BobGlicksman/Annunciator/Hardware/Annunciator parts list.pdf

ITEM | PART NUMBER | MFG OR URL | DESCRIPTION | QTY | UNIT COST EXTENDED COST | NOTES
1 Y11-2800069A | JLCPCB | Animatronic Mouth PCB | 1 | $2.33 | $2.33 total of 10 boards on order
2 Photon | Particle | Particle Photon 1 | 1 | $20.00 | $20.00
| | | | | | I also have 5 non-P versions -- slightly higher power but they work fine.

3

### 12 position female pin

header

https://www.amazon.com/Chanzon-Straight-Connector-Breadboard-Electronic/dp/B09MYKK2LV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 nRYEE9crsHyvb23IP-20ZdZeSVpxvLQWY8b1HdikOeQXo55bN5OvMTJjQL FRWxnOPZgaVZfYDvwrfyCHepdl4O8RvLrjoj43uc4O9xBdr-1iHb4tNBI4Tawv0GX3YywN8-H7Nls2inTW9yNwj-L23P9FFmD5l5ra8m0XVdx2YJUGXv07NFlGx5vGHzk 7ZFUFrYhaRYK8cK1jigX4Dxft1rs.0LHUbsUPH67owT L6byUosg1IiVrwncu3ehRr6-
jXavk&dib_tag=se&keywords=12%2Bpin%2Bfemale
%2Bheader&qid=1744849629&sprefix=12%2Bpin%
2Bfemale%2Bheader%2Caps%2C258&sr=8-4&th=1 12 pin female header, pcb mount | 2 | $0.50 | $1.00 URL is for 10 pcs

4 74HCT125N

https://www.digikey.com/en/products/detail/texas-
instruments/SN74HCT125N/376860 | Quad Tristate driver, TTL level, non-inv. | 1 | $0.63 | $0.63

### 5 Socket, 14 pin

https://www.amazon.com/uxcell-2-54mm-Soldering-Socket-Adaptor/dp/B07H3WQYRQ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 EALaU3pVoE1LwHUuFkKhaxR6vCGmxljUArKusNRUKvnl A-VRif2UGHYDCarszrOfulmSilFftBcoGowjmH3BneBfIw08VRZCU3pqD1gH5IPZfksUx-Th7oCVgRJOAkPr0ZbPxcMwBGcvB7RXs0kBuCuzddkaqe6pv aMmh19ilpAqmxtK9S_RUCmzYH04kI61MIibgpgspTp h-lE0pbnwvU.icjyUkQsbgvTHvpMFriUBUrfxbnpt2abpGHPsOCUZE&dib_tag=se&keywords=14
+pin+DIP+socket&qid=1744761619&sprefix=14+pin
+dip+socket%2Caps%2C251&sr=8-3 | 14 pin DIP socket | 1 | $0.17 | $0.17 URL is for 40 pcs

### 6 Mini MP3 player

https://www.amazon.com/dp/B08V8G1TQZ?ref=ppx
_yo2ov_dt_b_fed_asin_title&th=1 | DF Player mini MP3 Player Module | 1 | $2.25 | $2.25 URL is for 4 pcs

7 8 pin female pin header

https://www.amazon.com/Yohii-Female-Headers-2-54mm-Single/dp/B07PLBC2GT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 5ALn7GxSpyurLsKLO7Mo0innP73vNRrW2urV9aZzf7 R9ZNpbpXsr85012Vc7eYjePs6cmqFkM2PMgXwEQR THL4drI8LmCivl1xsj0kDyehfGPwIdw5KbTMyKq_ICdT DcA-HBCNLd7zU0Mqh03WsxYAuKVKsJSIlvwjlBN54N4fh 271EIu8QTKFcZrYUSP6mGxgcui8z2ChFMa90gqnrw 0FBo.8B6mlDOUBwwXZoe55-
ZnuPGGpWiwA5H8nYQyi1kOhc8&dib_tag=se&keyw
ords=8+pin+female+header&qid=1744849451&spr
efix=8+pin+female+header%2Caps%2C191&sr=8-3 8 pin female pin headers, pcb mount | 2 | $0.16 | $0.32 URL is for 50 pcs
8 terminal block, 2 pin | https://www.adafruit.com/product/724 | 2 pin, 3.5 mm terminal block | 1 | $0.59 | $0.59 URL is for 5 pcs
9 micro SD card | https://www.amazon.com/dp/B07Z7V34RG?ref=ppx
| _yo2ov_dt_b_fed_asin_title&th=1 | micro SD card, 32 Gbyte | 1 | $5.00 | $5.00 URL is for 2 pcs

### 10 USB PCB connector

https://www.amazon.com/Female-Type-B-4-Pin-Socket-MXRS/dp/B07F6L1DHR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 cyTw-9mF5pKvzrcHB7jTNxwDf6Ug8ol5UrxFIZORXRy44IlJ mPznzqloNWZEGh5lIZ5Lm7IxRCbhTa4C578RJmqhd 1FhxZufS9W6QNzNwdx5at9zRGtAC9LbRLapVVh6a UHk_vPMOfIRS-Ys3h8Zh30r0QwBJ6kevaZjq76z2iM.gu4h8SD0NV0N 9hxFtAnyBAFUr6PbOVRXyHhtJ6-
O4fM&dib_tag=se&keywords=USB+B+connector&qi
d=1744848348&sprefix=usb+b+connector%2Caps
%2C182&sr=8-3 | 1 | $0.60 | $0.60 URL is for 10 pcs

### 11 male pin header

https://www.amazon.com/dp/B07R5QDL8D?ref=pp
x_yo2ov_dt_b_fed_asin_title

breakable male pin header, 40 pins, 2.54
mm | 1 | $0.27 | $0.27 URL is for 20 strips, 40 pins each

12

Phono jack PCB
connector

https://www.amazon.com/QMseller-PJ-307-Stereo-Headphone-Connector/dp/B07XX8YGDX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 qfBAPIlAPGckIcNDKYjGiLjFdU8Zhp3gzSxwoZ4TuOc SbyPnUJGv3qlB3Ldf0BhFcEYV9HWrRRWq2RLtxh2Bhr0KDYnJfNmVEMup6FYyuT04Mj-y5aITX3O8-5C980IS0rSwliHBMXJKisSQkjki5szlMPstmLm0cE6G 85GdWI76Y.zUOz_4yxXi8yhPk_E036cwEk9LnMk0h WCvOAuHy8xsM&dib_tag=se&keywords=phono+jac k+pcb+connector&qid=1744849128&sprefix=phono +jack+pcb+connector%2Caps%2C174&sr=8-24&xpid=PEOrZotcPMnsB

PJ-307 3.5mm Stereo Jack Socket 5 Pin
PCB Mount Female Audio Headphone
Socket Connector | 1 | $0.47 | $0.47 URL is for 15 pcs
13 Loadspeaker | https://www.adafruit.com/product/1313 | 1 | $1.95 | $1.95

### 14 Red LED

https://www.amazon.com/Diode-Lights-120Pcs-Emitting-Assorted/dp/B0BY28JTFC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 Vkps4ikE12tjY0yF9U90AnTv6m9tKwqCMe8F2cgYOqu5T 5sBXjVYDNlY-SFkwtYLqvDdHWdlT6CYg4kvRYuNBcZLlcU0hRjYm3nSuWYLFPttIyTpxvkG3-yLnN6QtUinsVpc.4ApmabSVR-ZXlwQNI7db_pofeoIZTkJ5VvqVkDeOvY&dib_tag=se&keywords=red%2Bled%2B3mm&qid
=1744762661&sprefix=red%2Bled%2B3mm%2Cap
s%2C200&sr=8-3&th=1 | Red LED, 3 mm | 1 | $0.04 | $0.04 URL is for 120 pcs
15 Backlit pushbutton | https://www.adafruit.com/product/1440
| Green backlit pushbutton switch, panel
| mount | 1 | $1.50 | $1.50

### 16 Resistor, 470 ohm

https://www.digikey.com/en/products/detail/stackp
ole-electronics-inc/CF14JT470R/1741440 | Resistor, 470 ohm, 1/4 watt | 2 | $0.10 | $0.20

### 17 Resistor, 4.7 Kohm

https://www.digikey.com/en/products/detail/stackp
| ole-electronics-inc/CF14JT4K70/1741428 | Resistor, 4.7Kohm, 1/4/watt | 4 | $0.10 | $0.40
18 capacitor, 100 uF | https://www.digikey.com/en/products/detail/rubyco
| n/35YXJ100M6-3X11/3563127 | 100 uF electrolytic capacitor, 10 volt | 1 | $0.20 | $0.20
19 capacitor, 0.1 uF | https://www.adafruit.com/product/753 | 0.1 uF ceramic capacitor, PCB | 8 | $0.20 | $1.60 URL is for 10 pcs

TOTAL = | $39.51

MISC MOUNTING
HARDWARE FOR
ENCLOSURE
20 Screw; 6-32 x 1/2" | 4 | $0.00
21 Nut; 6-32 | 4 | $0.00
22 Screw; 4-40 x 1/4" | 8 | $0.00
23 Nut; 4-40 | 4 | $0.00

24

Threaded standoff, 4-40 x
1-3/4" | 4 | $0.00
25 Enclosure, custom | 1 | $0.00
