BobGlicksman/Annunciator/(commit log)

2025-03-21 Test SW - not functional
    Just some basic test software for Photon 1 to make sure that new board is functional.
2025-03-22 Basic test code
    MP3 player is playing and LEDs are flashing.
2025-03-23 version 0.5 - still WIP
    Implemented version, flashing green LED, user red LED to indicate on-line and ready.
2025-03-23 Minor bug fix to 0.5
    [Annunciator_code.ino]
2025-03-23 version 0.9
    Almost complete preliminary release. Needs parsing of the event data and using device ID to index into array of clips.
2025-04-12 Added enclosure .svg file
    Annunciator enclosure .svg file produced using inkscape for Epilog laser cutter and 3 mm plywood.
2025-05-25 sensor 6/7 no audio
2025-05-26 added front door as sensor 7
2025-06-03 bug fix for cloud device trip function
    [Annunciator_code.ino]
2025-06-08 version 1.0.2
    Added new clips 0200 - 0203 to support MOD announcements. *** NOTE: these clips are temporary - for demo to MN staff. They will be replaced by clips with the correct voice and staff designated messages.
    [Annunciator_code.ino, ClipsList.h]
2025-07-06 handle case of no previous clip
2025-12-09 fixed to not repeat older messages
    [Annunciator_code.ino]
